scott2006-L/MLX90640-Thermal-System/hardware/3d-model/打印生产单_给商家.pdf

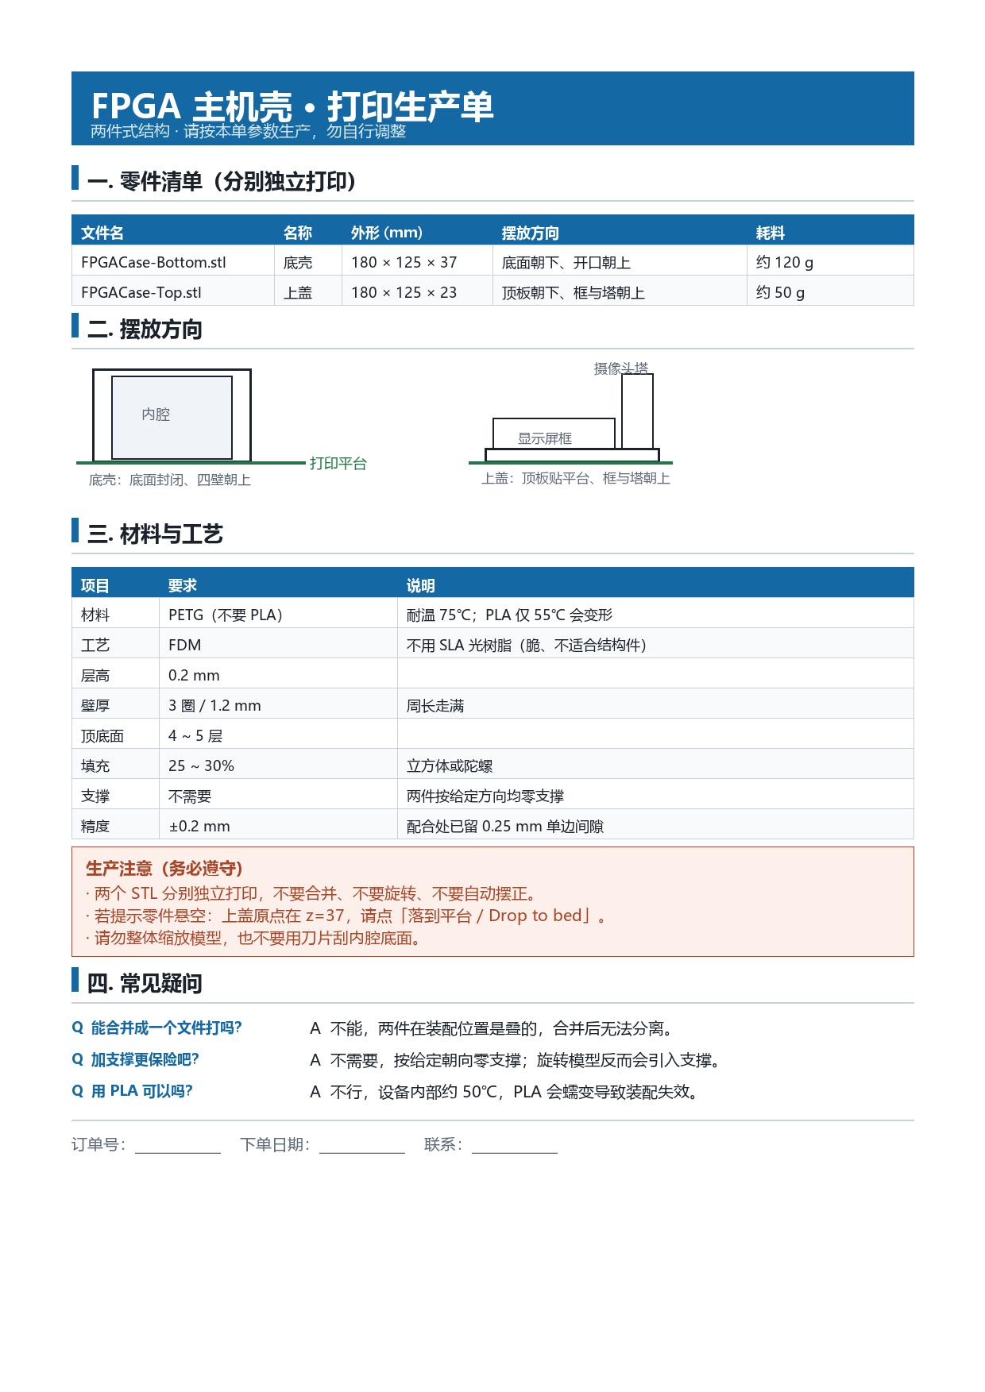
[picture p5: page 1]
