scott2006-L/MLX90640-Thermal-System/hardware/3d-model/FPGACase-Top.stl

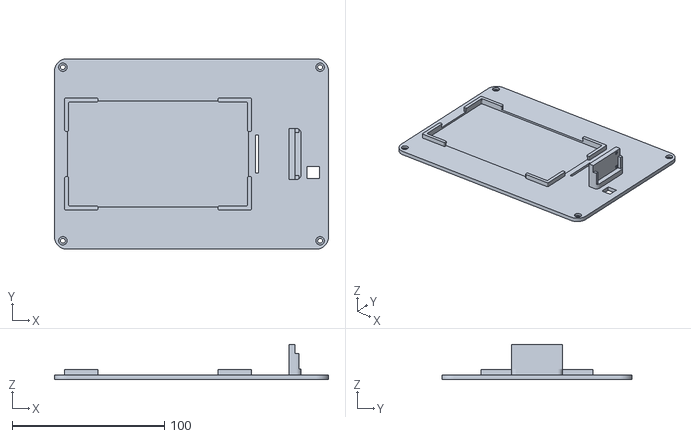
[picture p6: CAD file, 2026-11-04]
hardware/3d-model/FPGACase-Top.stl
180.0 x 125.0 x 23.0
