scott2006-L/MLX90640-Thermal-System/hardware/3d-model/FPGACase-Bottom.stl

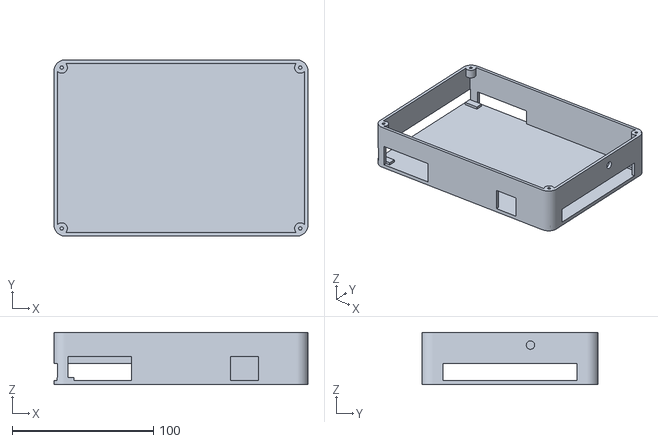
[picture p7: CAD file, 2026-11-04]
hardware/3d-model/FPGACase-Bottom.stl
180.0 x 125.0 x 37.0
