scott2006-L/MLX90640-Thermal-System/hardware/3d-model/装配说明书_自己用.pdf

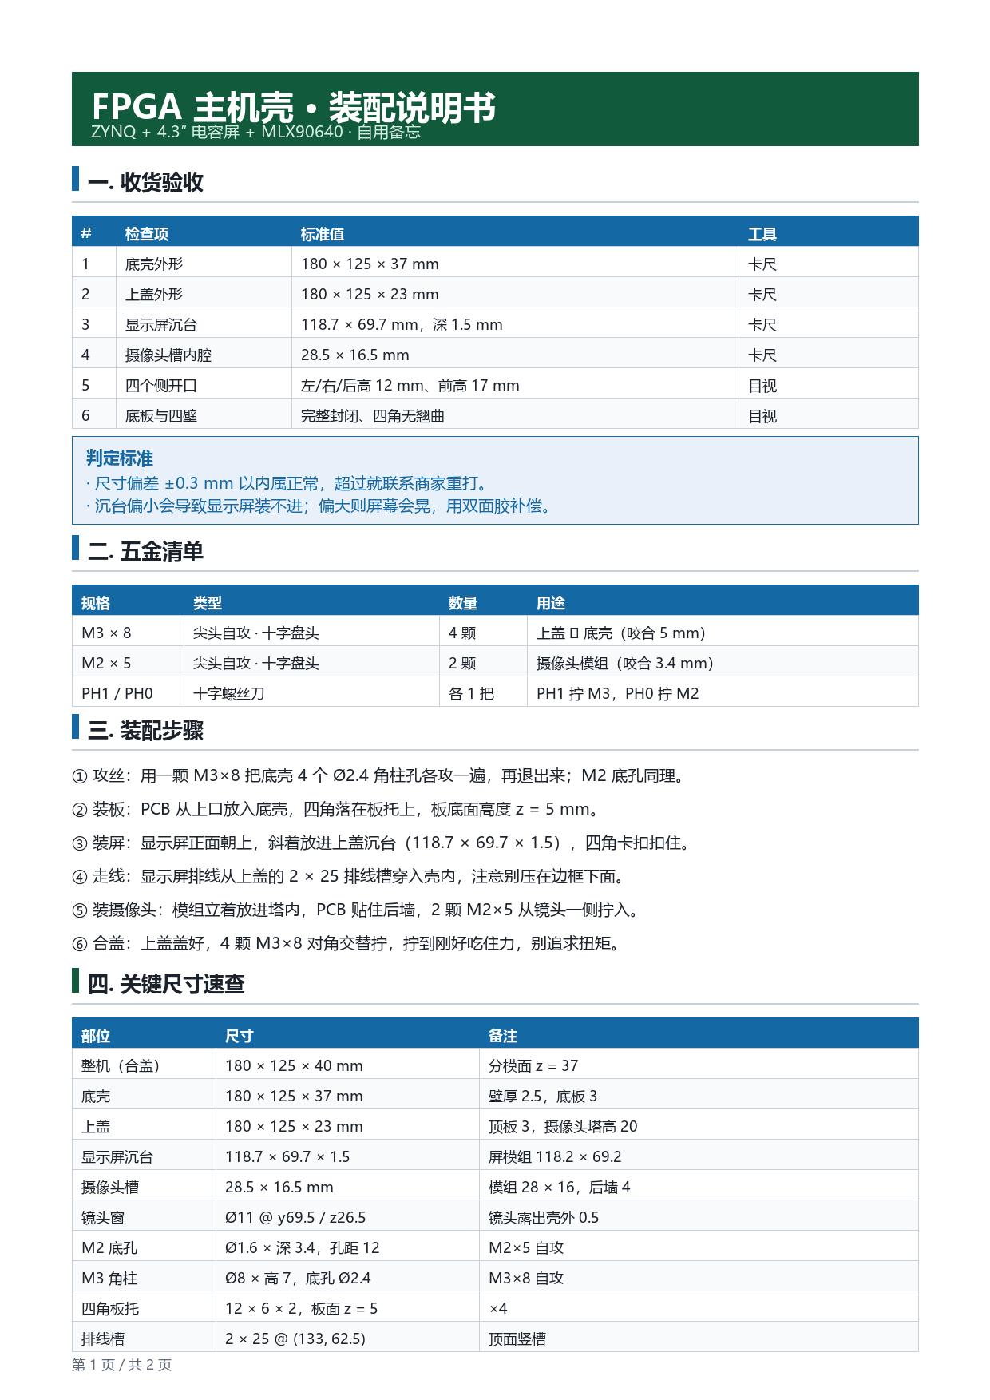
[picture p8: page 1]
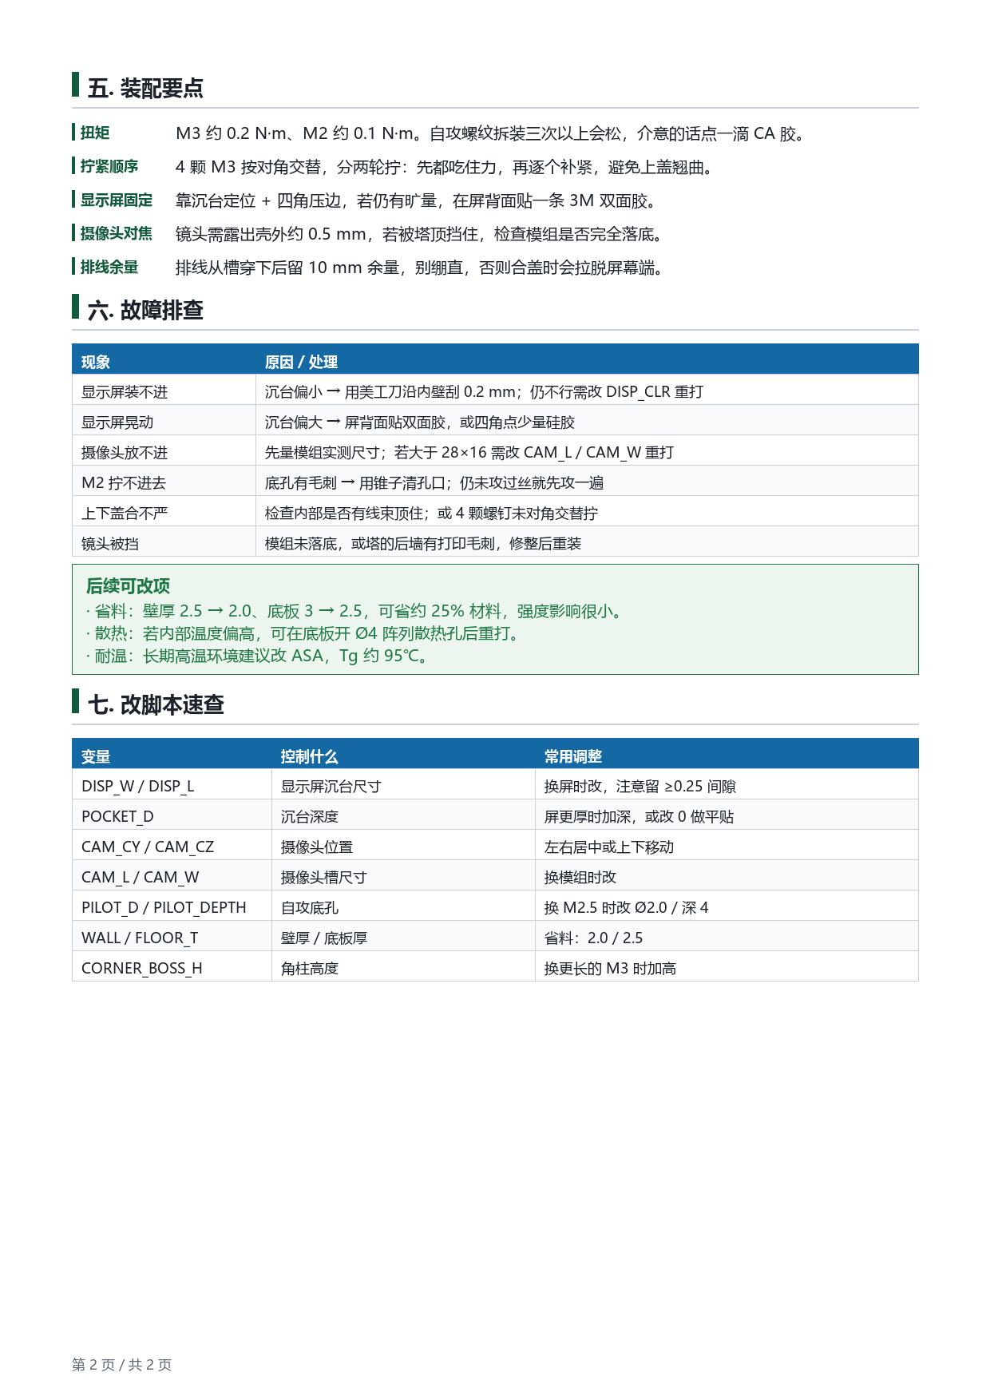
[picture p9: page 2]
