scott2006-L/MLX90640-Thermal-System/docs/7010 底板原理图.pdf

D

C

B

A | A

目录

# Page 1 目录

# 野火_ZYNQ7010 BTB 底板_原理图_V1.1

# Page 2 Page 3 Page 4 Page 5 Page 6

# Page 8

# Page 7

## 历史版本

电源

# BTB Connector

# 摄像头/SD卡/EEPROM

## 以太网PS

# Page 9 Page 10 Page 11

## 蜂鸣器器/按键/LED

音频

# Page 12

# LCD/RTC/JTAG

## 引出IO/串口

# Page 13

# HDMI USB

# Page 14

# CAN/RS485/RS232/ADC

## 以太网PL

Title

Size | Document Number | Rev
Date: | Sheet | of
| 目录 | V1.1

野火_ZYNQ7010底板_原理图

东莞野火电子技术有限公司
https://yehuosm.tmall.com

A4
Saturday, December 02, 2023 | 1 | 14

Title

目录 | V1.1

野火_ZYNQ7010底板_原理图

东莞野火电子技术有限公司
https://yehuosm.tmall.com
Saturday, December 02, 2023 | 1 | 14

Title

目录 | V1.1

野火_ZYNQ7010底板_原理图

东莞野火电子技术有限公司
https://yehuosm.tmall.com
Saturday, December 02, 2023 | 1 | 14

D

C

B

A | A

# 历史版本

## 版本号

V0.1 | 2020-10-26
| 日期 | 设计 | 描述
| | xgh | 初始版本
V1.0 | 2023-06-26 | ghs | BTB初始版本
V1.1 | 2023-09-19 | ghs | 修正JTAG接口定义错误，修正音频接口封装错误

Title

历史版本 | V1.1

野火_ZYNQ7010底板_原理图

东莞野火电子技术有限公司
https://yehuosm.tmall.com
Saturday, December 02, 2023 | 2 | 14

Title

历史版本 | V1.1

野火_ZYNQ7010底板_原理图

东莞野火电子技术有限公司
https://yehuosm.tmall.com
Saturday, December 02, 2023 | 2 | 14

Title

历史版本 | V1.1

野火_ZYNQ7010底板_原理图

东莞野火电子技术有限公司
https://yehuosm.tmall.com
Saturday, December 02, 2023 | 2 | 14

D

# DC IN : 12V

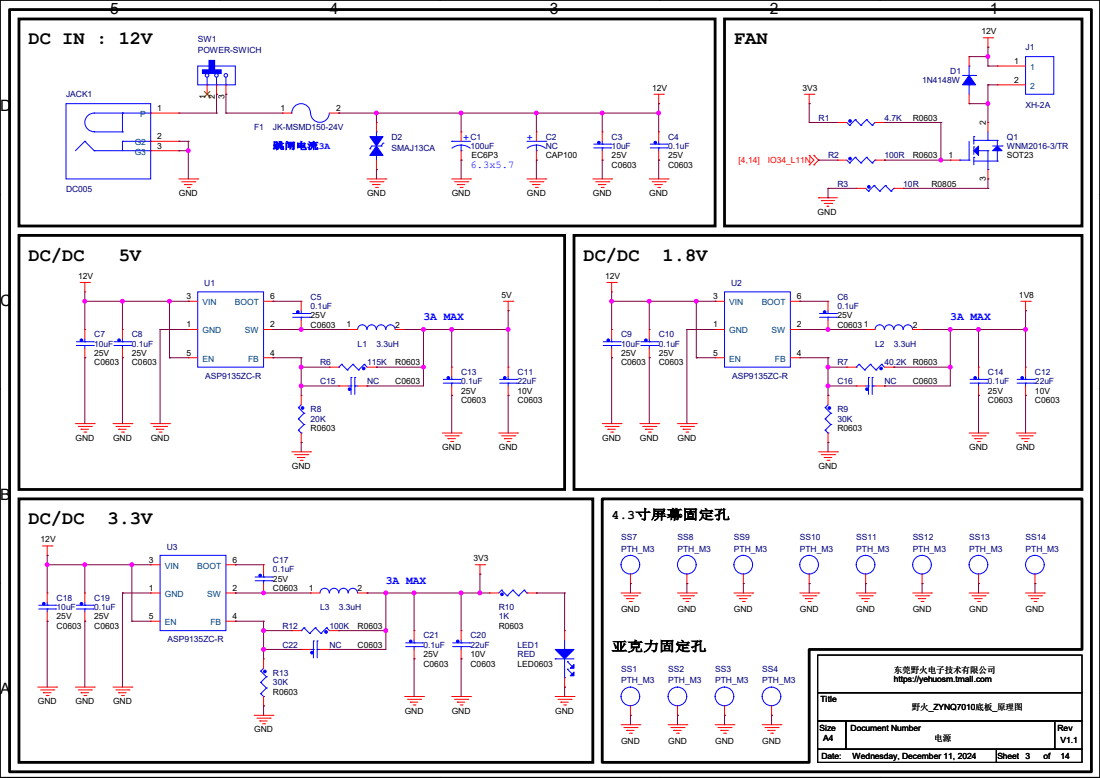
[picture p10: page 3]

东莞野火电子技术有限公司
https://yehuosm.tmall.com

# BTB Connector

# PS_IO

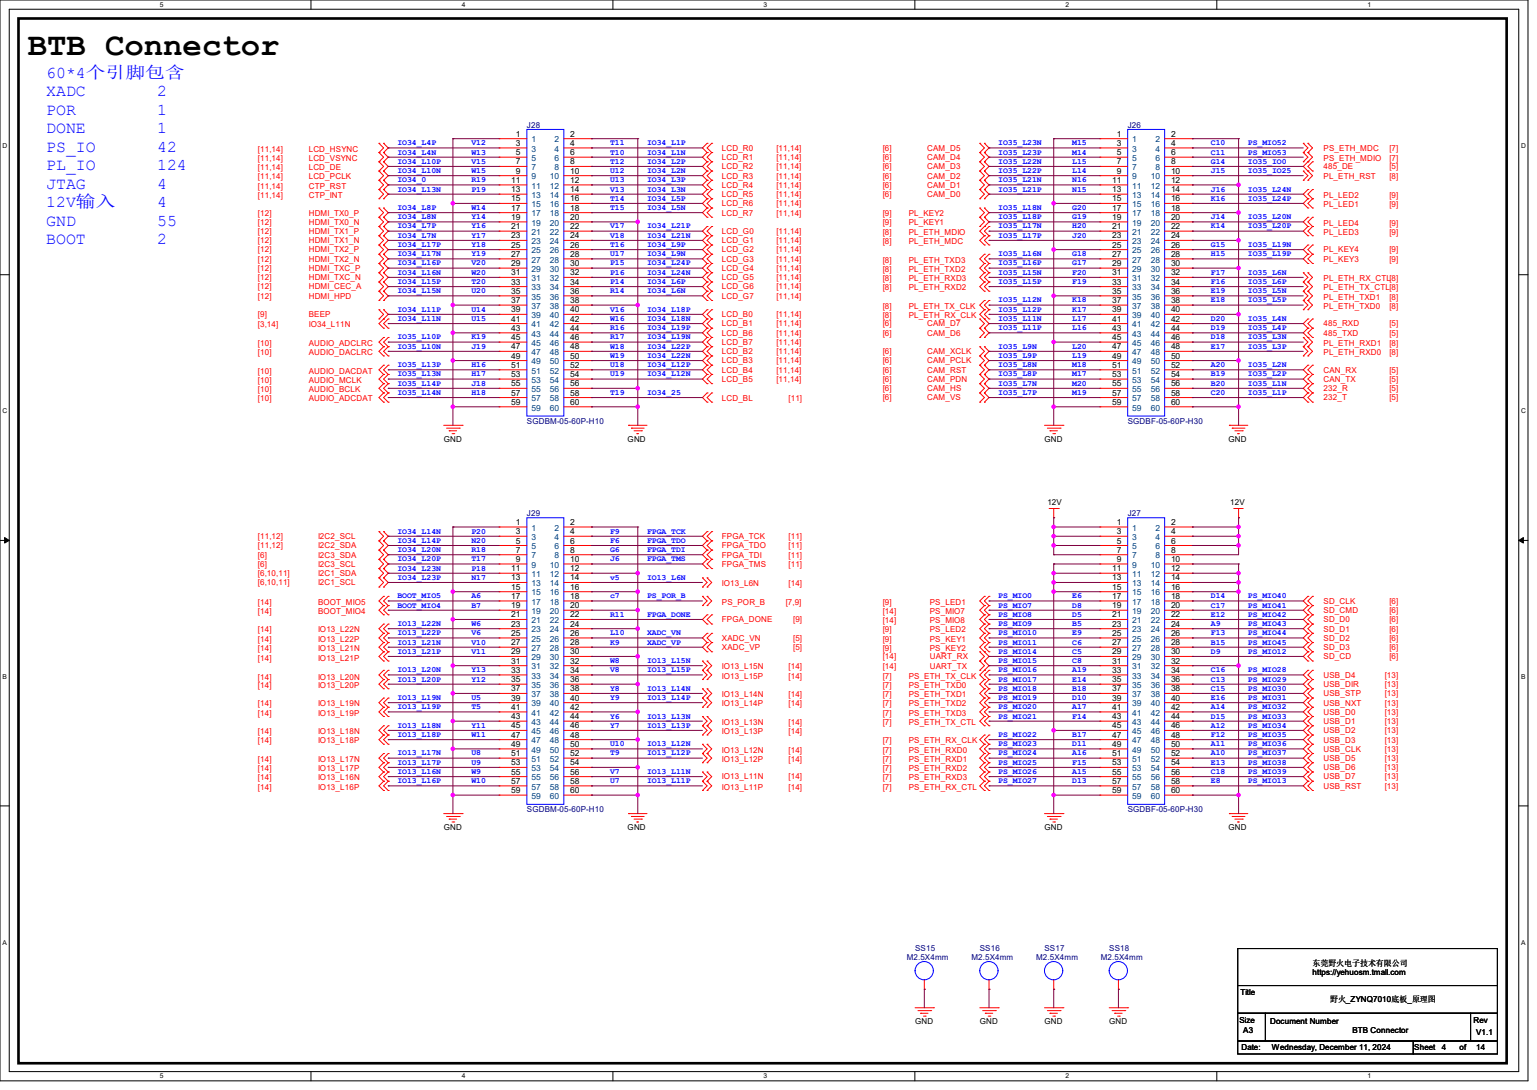
[picture p11: page 4]

东莞野火电子技术有限公司
https://yehuosm.tmall.com

D

CAN | RS485

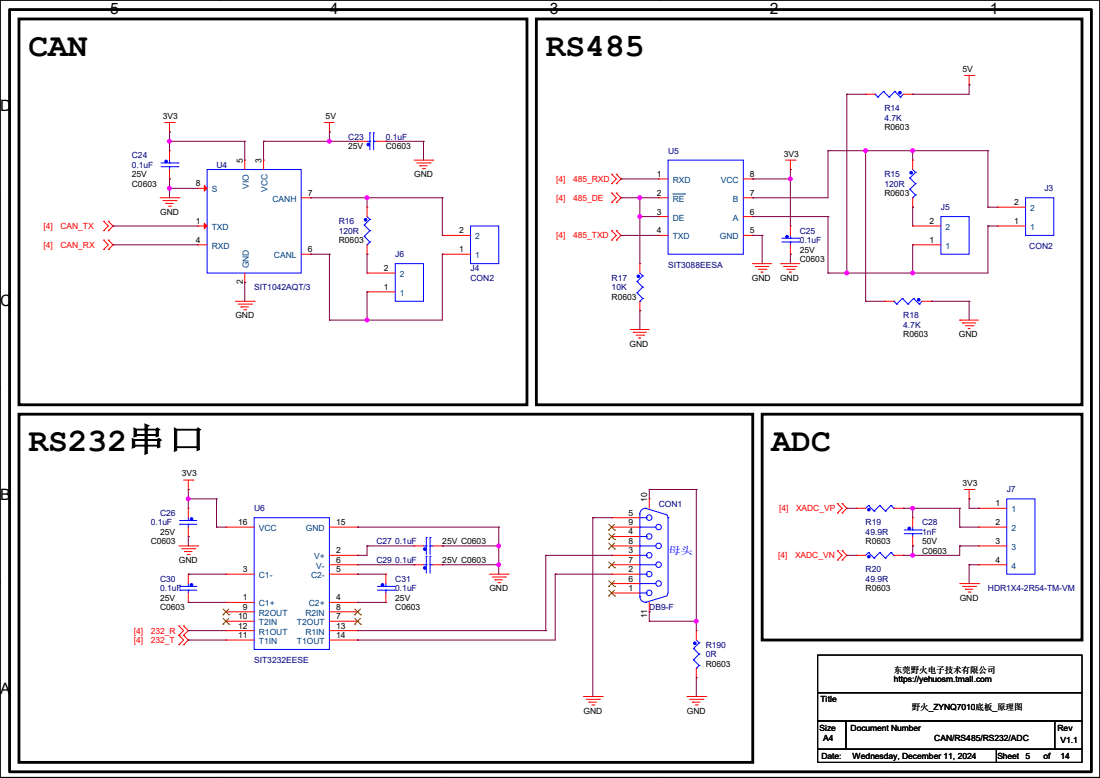
[picture p12: page 5]

东莞野火电子技术有限公司
https://yehuosm.tmall.com

D

# SD卡

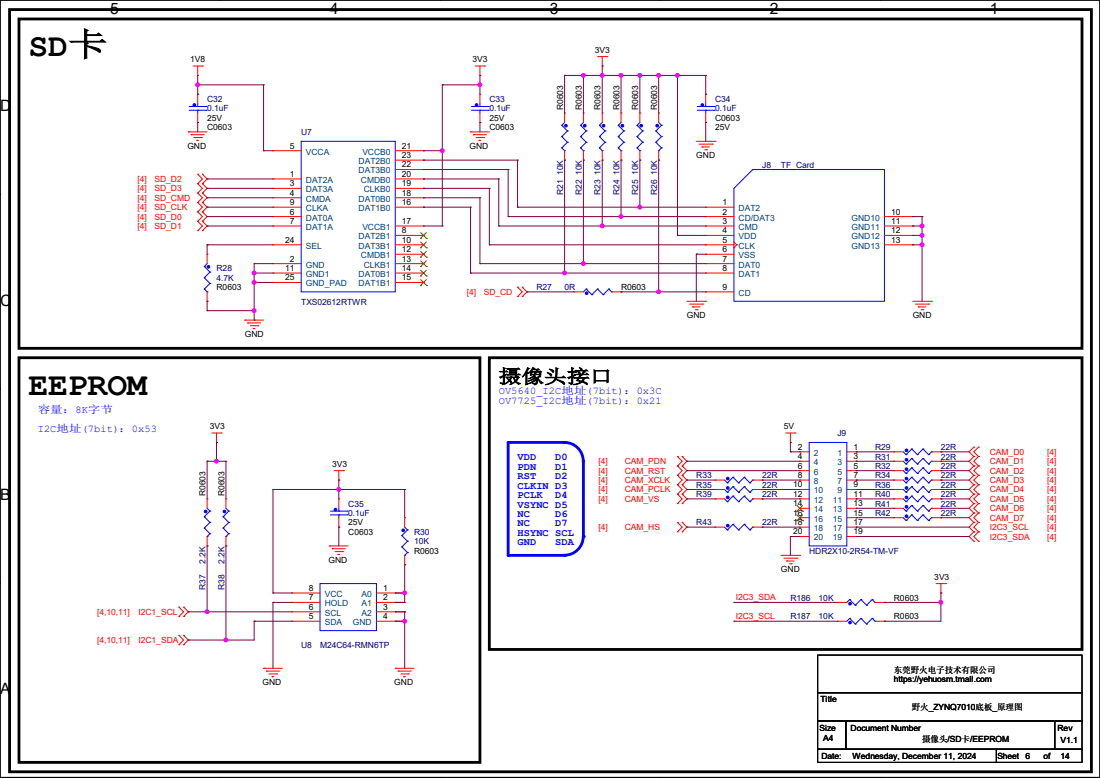
[picture p13: page 6]

东莞野火电子技术有限公司
https://yehuosm.tmall.com

# 以太网PS

## TXC / RXC : delays 2ns

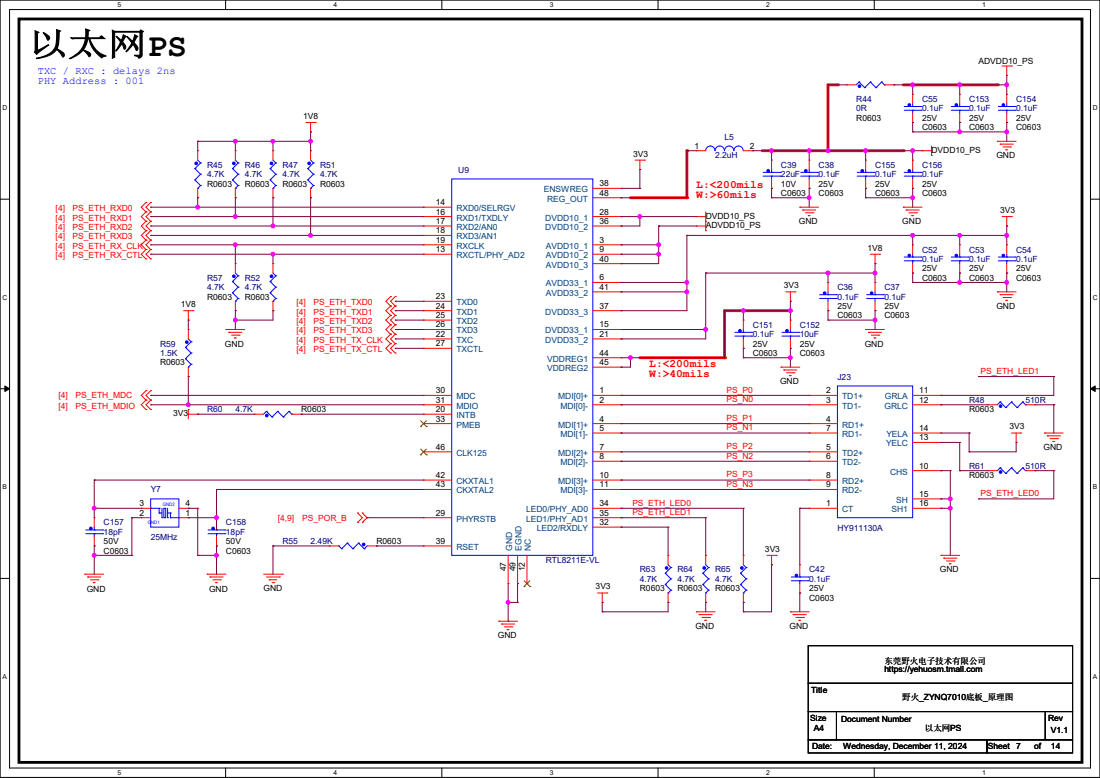
[picture p14: page 7]

东莞野火电子技术有限公司
https://yehuosm.tmall.com

D

# 以太网接口PL

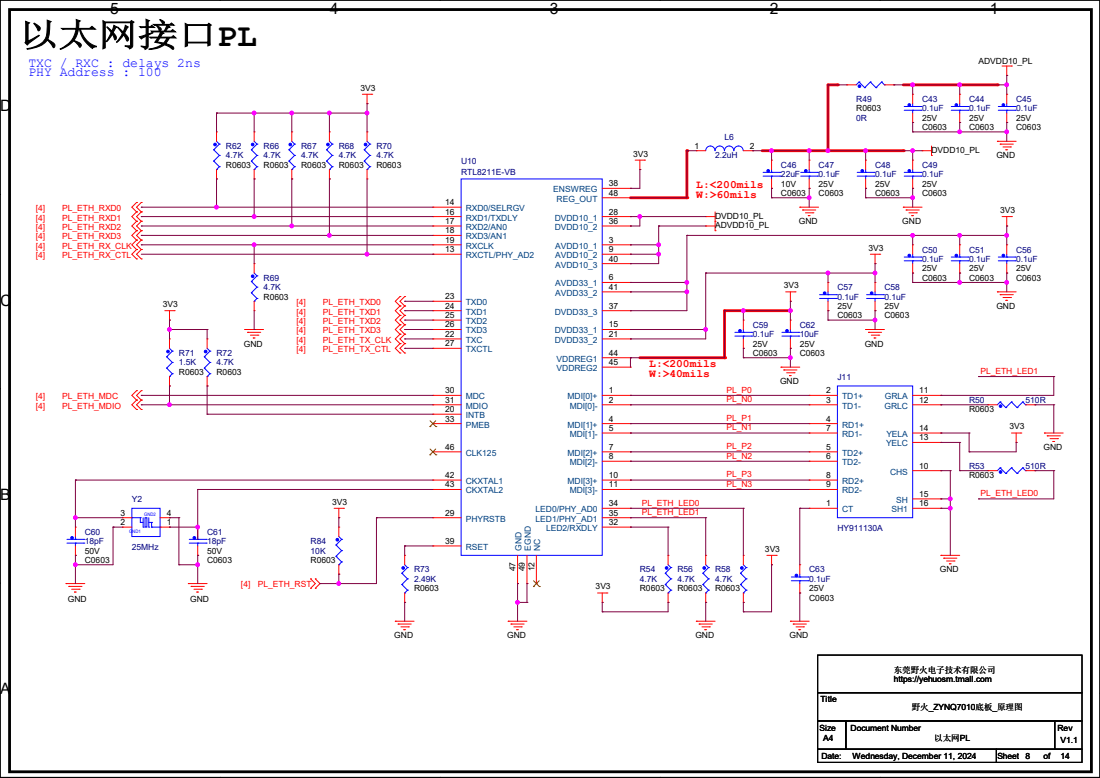
[picture p15: page 8]

东莞野火电子技术有限公司
https://yehuosm.tmall.com

D

# 蜂鸣器

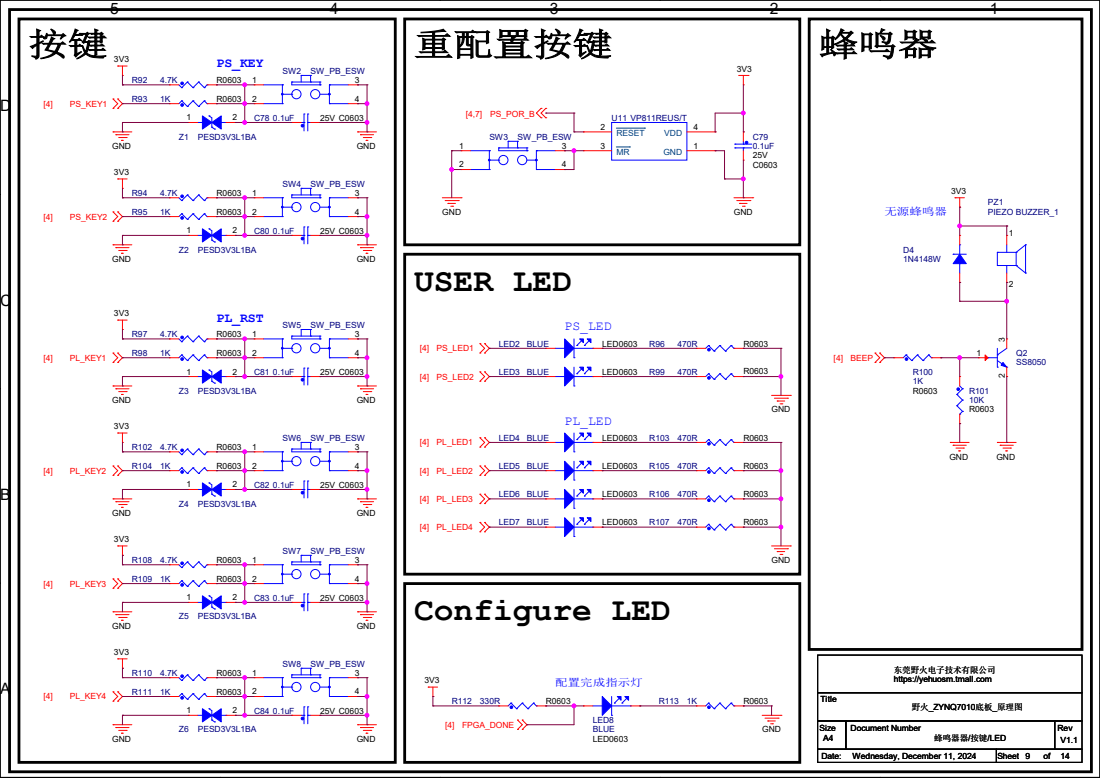
[picture p16: page 9]

东莞野火电子技术有限公司
https://yehuosm.tmall.com

D

音频

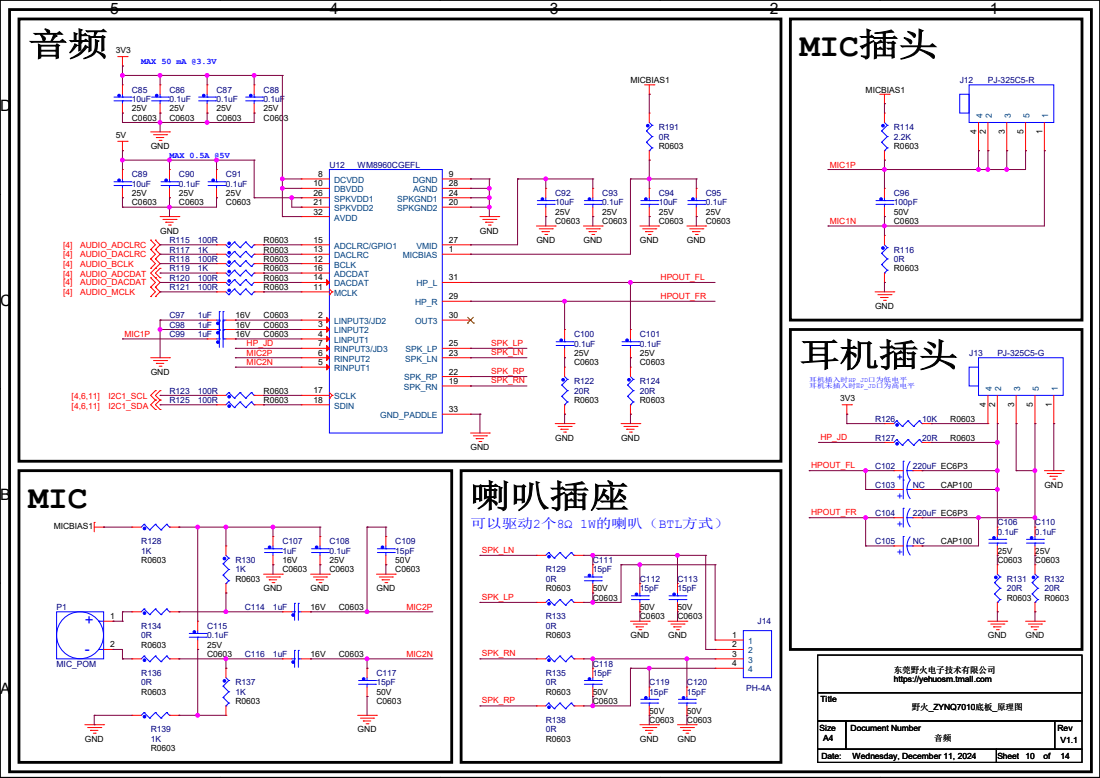
[picture p17: page 10]

东莞野火电子技术有限公司
https://yehuosm.tmall.com

D

# LCD RGB888

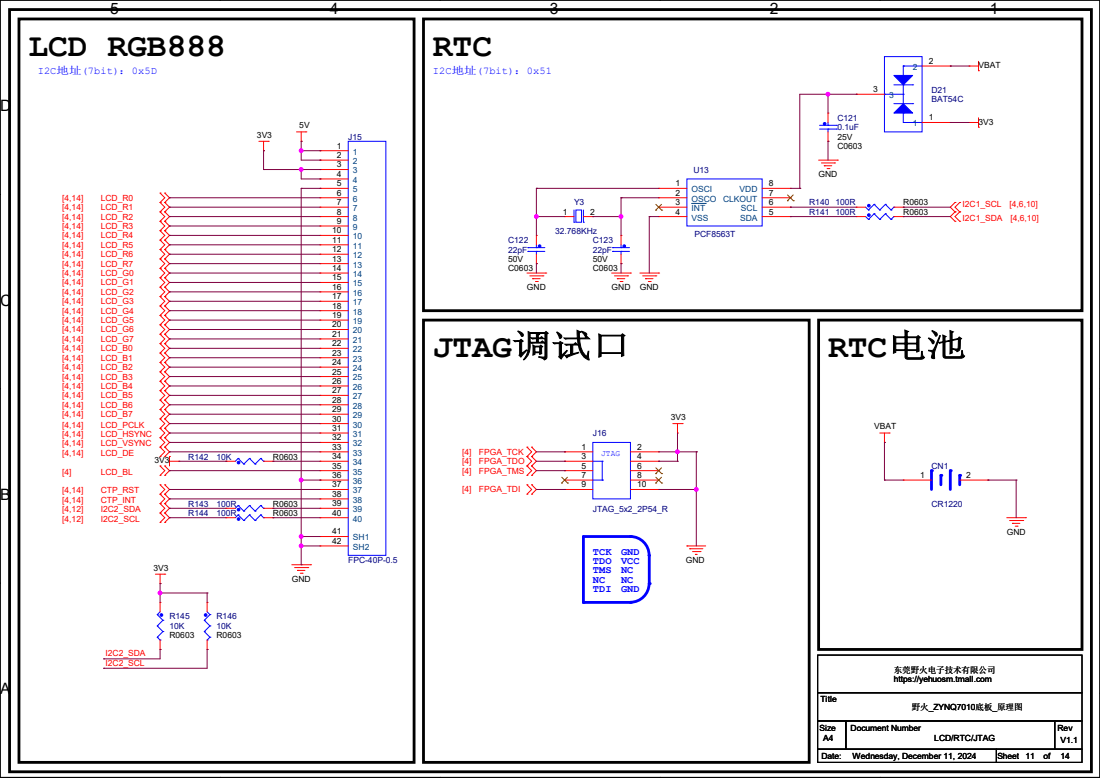
[picture p18: page 11]

东莞野火电子技术有限公司
https://yehuosm.tmall.com

D

# Type A型

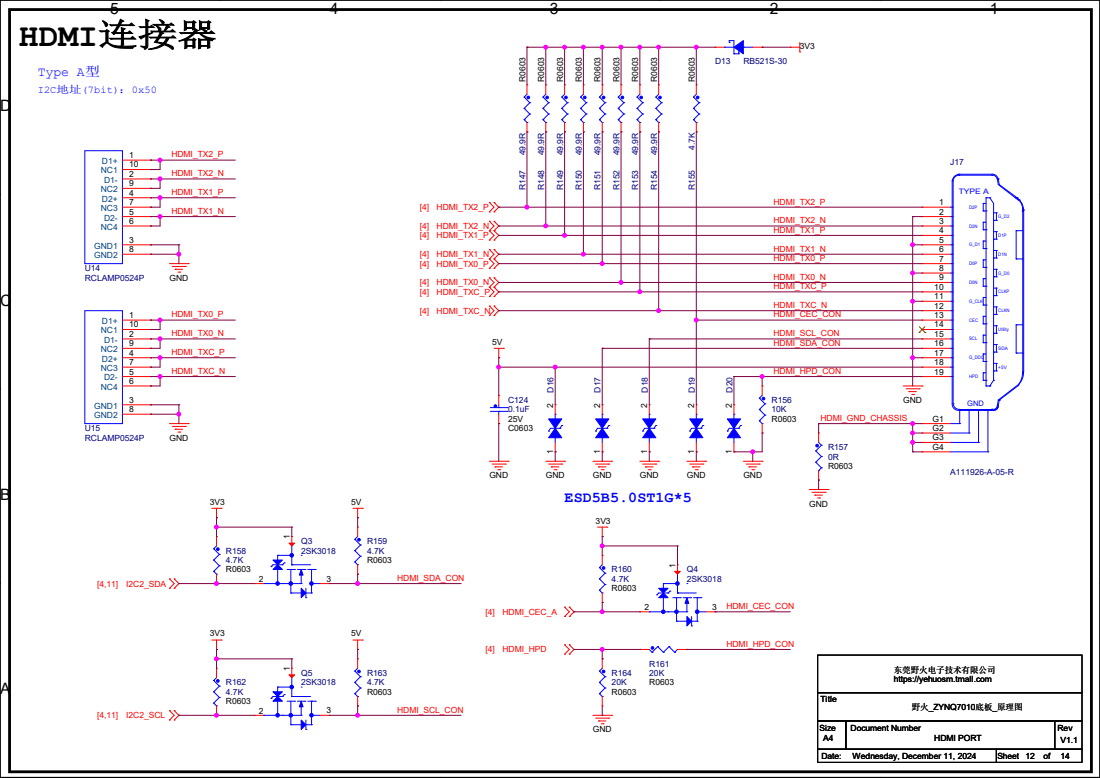
[picture p19: page 12]

HDMI_TX1_P | 4
HDMI_TX1_N | 5
HDMI_TX0_P | 7
HDMI_TX0_N | 8
HDMI_TXC_P | 10
HDMI_TXC_N | 11
HDMI_CEC_CON | 13
HDMI_SCL_CON | 14 15
HDMI_SDA_CON | 16

东莞野火电子技术有限公司
https://yehuosm.tmall.com

# USB HUB

# USB PHY

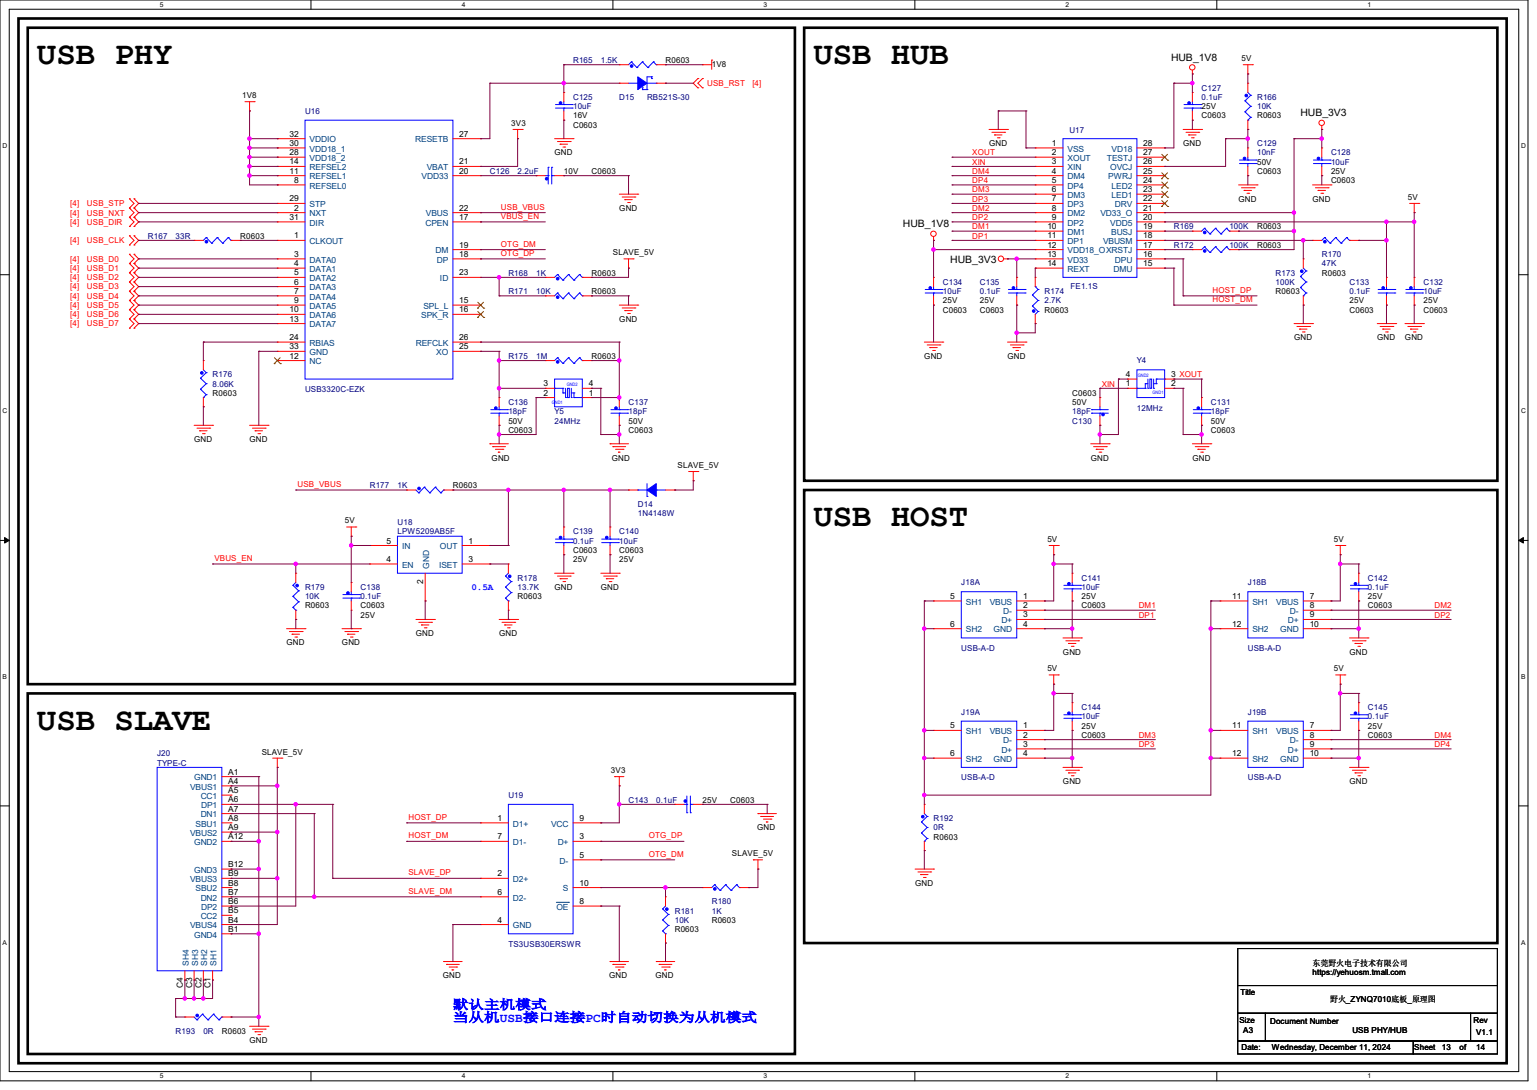
[picture p20: page 13]

东莞野火电子技术有限公司
https://yehuosm.tmall.com

D

# 引出IO口 BANK13 XC7Z020 Only

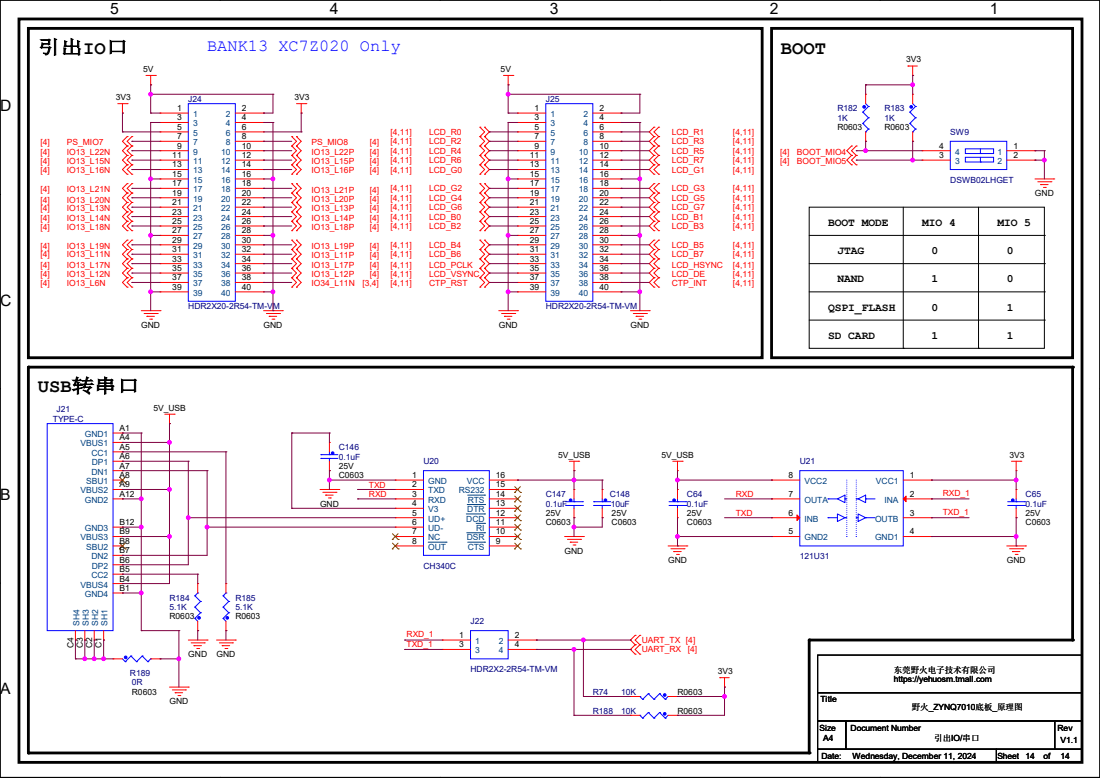
[picture p21: page 14]

东莞野火电子技术有限公司
https://yehuosm.tmall.com
