scott2006-L/MLX90640-Thermal-System/(commit log)

2026-11-04 feat: MLX90640 红外热成像与热斑监测系统 v1.0
    - PL: 480x272 RGB 屏时序驱动、双端口显存、3.05kHz 蜂鸣器方波
    - PS: MLX90640 采集与温度补偿、热斑判定、伪彩色映射、信息区点阵字体
    - 硬件: 4.3 寸屏 29 引脚映射表、FPGA 外壳 3D 模型、底板原理图
    - 文档: 24 页技术文档（含 6 个关键工程问题的现象/根因/解决）
    - 上位机: Python 实时热力图可视化
    [FPGACase-Bottom.stl, FPGACase-Top.stl]
2026-11-04 docs: 补充人手红外热图与上位机界面实测图，技术文档更新至 25 页
